sundbyk/dragon-rom-and-floppy-emulator/autoboot_stub.h

// autoboot.s assembled for $E000. See there for how to make this again.
#define AUTOBOOT_STUB_ADDRESS	0xE000
#define AUTOBOOT_CMD_OFFSET	65	// where CMD is

static const uint8_t autoboot_stub[AUTOBOOT_CMD_OFFSET] = {
	0xB6,0x01,0x6A,0xB7,0x01,0xDA,0xBE,0x01,0x6B,0xBF,0x01,0xDB,0x30,0x8D,0x00,0x31,
	0xBF,0x01,0xDD,0x30,0x8D,0x00,0x0B,0xBF,0x01,0x6B,0x86,0x7E,0xB7,0x01,0x6A,0x7E,
	0x83,0x71,0x34,0x14,0xBE,0x01,0xDD,0xA6,0x80,0xBF,0x01,0xDD,0x81,0x0D,0x26,0x0C,
	0xF6,0x01,0xDA,0xF7,0x01,0x6A,0xBE,0x01,0xDB,0xBF,0x01,0x6B,0x35,0x14,0x32,0x62,
	0x39
};
