sundbyk/dragon-rom-and-floppy-emulator/(commit log)

2026-11-03 Drive B, BREAK to BASIC, CoCo BASIC fixes and a user manual
    - Second floppy drive: each drive has its own track buffer and head position, the
    latch's drive select switches between them. SHIFT+ENTER in the menu puts a disk in B
    - BREAK in the top folder of the menu goes to BASIC
    - coco.rom with its halves the wrong way round is swapped on loading
    - MANUAL.md: how to use it, in English
    Based on dragon-rom-and-floppy-emulator by kernelcrash (MIT)
2026-11-03 The board: photos, what is on it, how to get one
    Board V1.2 has no connection to cartridge pin 40, so a BASIC ROM of your own can not be used
    with it. README and MANUAL say so.
2026-11-04 Drive letters in the menu, SHIFT+ENTER fixed, blank disks, emulated upper RAM test
    - Menu: a letter after each entry's block (D disk, R rom, C cassette), and an inverted
    A or B on the disks in the drives. The firmware tells the menu which entries they are
    - SHIFT+ENTER: BASIC never reports ENTER while SHIFT is held down (same keyboard row),
    so the menu looks at the keys itself. The status row says what happened to drive B
    - disks/: blank DragonDOS (.vdk) and RS-DOS (.dsk) disks, and RAM64TEST.cas
    - Emulated upper RAM, for trying it out: with ram64.on on the SD card, $FF5F puts 32K
    of the board's RAM at $8000-$FEFF (with !DSD for $8000-$BFFF), $FF5E takes it away.
    tools/ram64test.s te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
